machineroom/rpi_c011/PCB/c011_link.kicad_pcb

## KiCad design PCB/c011_link.kicad_pcb (2022-03-19)

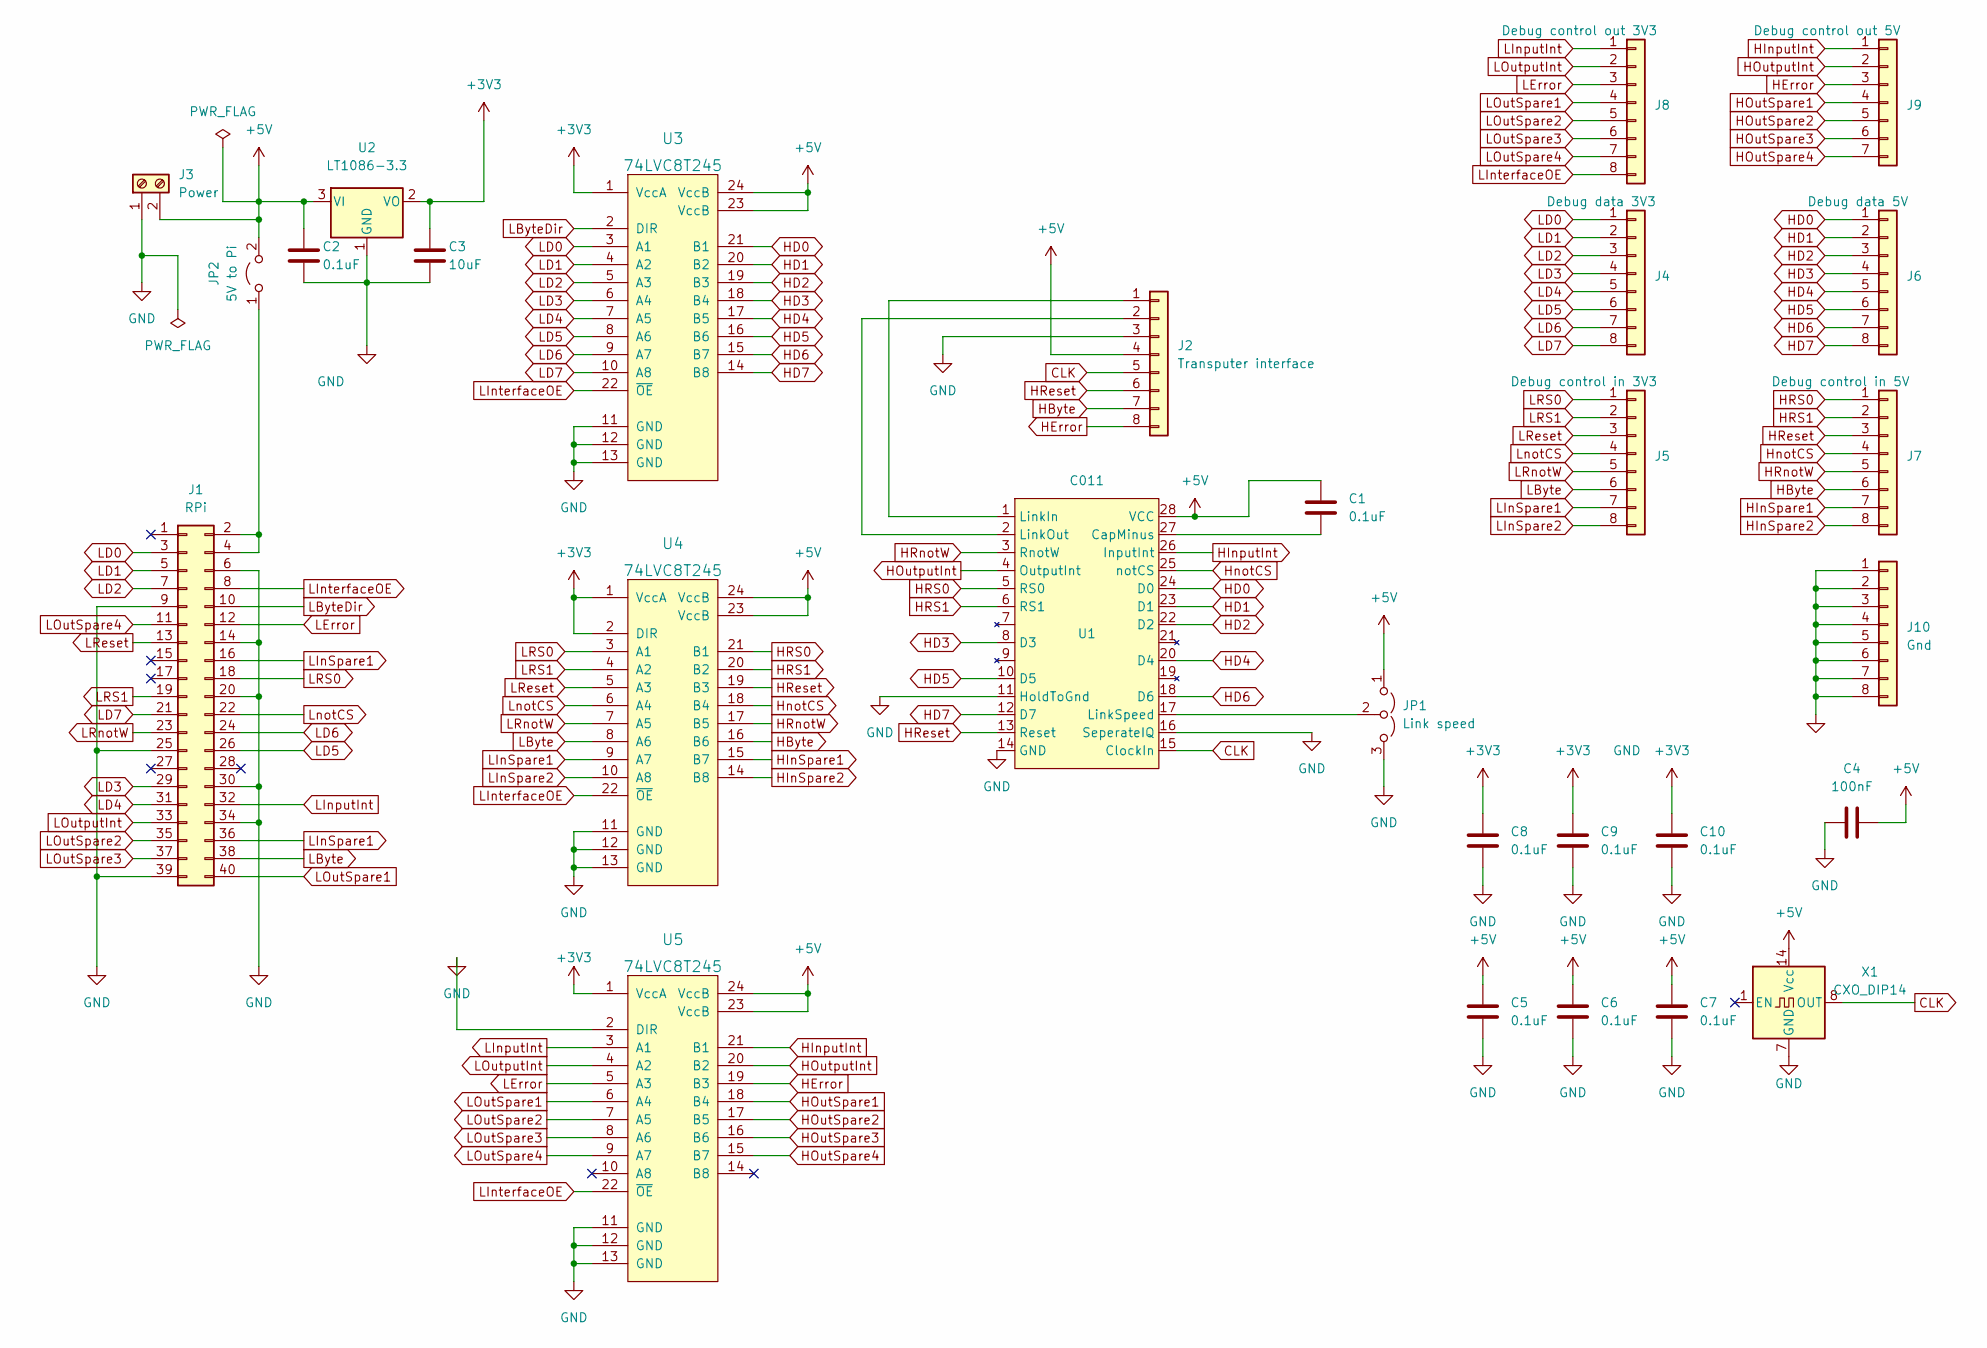
[picture p2: schematic c011_link.kicad_sch]

Parts:
C1, C2: 0.1uF; C_Disc_D5.0mm_W2.5mm_P5.00mm
C3: 10uF; CP_Radial_Tantal_D5.0mm_P2.50mm
C4: 100nF; C_Disc_D5.0mm_W2.5mm_P5.00mm
C5, C6, C7, C8, C9, C10: 0.1uF; C_0402_1005Metric_Pad0.74x0.62mm_HandSolder
J1: RPi; PinHeader_2x20_P2.54mm_Vertical
J2: Transputer interface; PinHeader_1x08_P2.54mm_Vertical
J3: Power; TerminalBlock_bornier-2_P5.08mm
J4: Debug data 3V3; PinHeader_1x08_P2.54mm_Vertical
J5: Debug control in 3V3; PinHeader_1x08_P2.54mm_Vertical
J6: Debug data 5V; PinHeader_1x08_P2.54mm_Vertical
J7: Debug control in 5V; PinHeader_1x08_P2.54mm_Vertical
J8: Debug control out 3V3; PinHeader_1x08_P2.54mm_Vertical
J9: Debug control out 5V; PinHeader_1x07_P2.54mm_Vertical
J10: Gnd; PinHeader_1x08_P2.54mm_Vertical
JP1: Link speed; PinHeader_1x03_P2.54mm_Vertical
JP2: 5V to Pi; PinHeader_1x02_P2.54mm_Vertical
U1: C011; DIP-28_W15.24mm
U2: LT1086-3.3; TO-220-3_Horizontal_TabDown
U3, U4, U5: 74LVC8T245; SOIC-24W_7.5x15.4mm_P1.27mm
X1: CXO_DIP14; Oscillator_DIP-14

Connections:
+3V3: C3.1, C8.1, C9.1, C10.1, U2.2 (VO), U3.1 (VccA), U4.1 (VccA), U4.2 (DIR), U5.1 (VccA)
+5V: C1.1, C2.1, C4.1, C5.1, C6.1, C7.1, J2.4, J3.2, JP1.1 (A), JP2.2 (B), U1.28 (VCC), U2.3 (VI), U3.23 (VccB), U3.24 (VccB), U4.23 (VccB), U4.24 (VccB), U5.23 (VccB), U5.24 (VccB), X1.14 (Vcc)
CLK: J2.5, U1.15 (ClockIn), X1.8 (OUT)
GND: C2.2, C3.2, C4.2, C5.2, C6.2, C7.2, C8.2, C9.2, C10.2, J1.6, J1.9, J1.14, J1.20, J1.25, J1.30, J1.34, J1.39, J2.3, J3.1, J10.1, J10.2, J10.3, J10.4, J10.5, J10.6, J10.7, J10.8, JP1.3 (B), U1.11 (HoldToGnd), U1.14 (GND), U1.16 (SeperateIQ), U2.1 (GND), U3.11 (GND), U3.12 (GND), U3.13 (GND), U4.11 (GND), U4.12 (GND), U4.13 (GND), U5.2 (DIR), U5.11 (GND), U5.12 (GND), U5.13 (GND), X1.7 (GND)
HByte: J2.7, J7.6, U4.16 (B6)
HD0: J6.1, U1.24 (D0), U3.21 (B1)
HD1: J6.2, U1.23 (D1), U3.20 (B2)
HD2: J6.3, U1.22 (D2), U3.19 (B3)
HD3: J6.4, U1.8 (D3), U3.18 (B4)
HD4: J6.5, U1.20 (D4), U3.17 (B5)
HD5: J6.6, U1.10 (D5), U3.16 (B6)
HD6: J6.7, U1.18 (D6), U3.15 (B7)
HD7: J6.8, U1.12 (D7), U3.14 (B8)
HError: J2.8, J9.3, U5.19 (B3)
HInSpare1: J7.7, U4.15 (B7)
HInSpare2: J7.8, U4.14 (B8)
HInputInt: J9.1, U1.26 (InputInt), U5.21 (B1)
HOutSpare1: J9.4, U5.18 (B4)
HOutSpare2: J9.5, U5.17 (B5)
HOutSpare3: J9.6, U5.16 (B6)
HOutSpare4: J9.7, U5.15 (B7)
HOutputInt: J9.2, U1.4 (OutputInt), U5.20 (B2)
HRS0: J7.1, U1.5 (RS0), U4.21 (B1)
HRS1: J7.2, U1.6 (RS1), U4.20 (B2)
HReset: J2.6, J7.3, U1.13 (Reset), U4.19 (B3)
HRnotW: J7.5, U1.3 (RnotW), U4.17 (B5)
HnotCS: J7.4, U1.25 (notCS), U4.18 (B4)
LByte: J1.38, J5.6, U4.8 (A6)
LByteDir: J1.10, U3.2 (DIR)
LD0: J1.3, J4.1, U3.3 (A1)
LD1: J1.5, J4.2, U3.4 (A2)
LD2: J1.7, J4.3, U3.5 (A3)
LD3: J1.29, J4.4, U3.6 (A4)
LD4: J1.31, J4.5, U3.7 (A5)
LD5: J1.26, J4.6, U3.8 (A6)
LD6: J1.24, J4.7, U3.9 (A7)
LD7: J1.21, J4.8, U3.10 (A8)
LError: J1.12, J8.3, U5.5 (A3)
LInSpare1: J1.16, J1.36, J5.7, U4.9 (A7)
LInSpare2: J5.8, U4.10 (A8)
LInputInt: J1.32, J8.1, U5.3 (A1)
LInterfaceOE: J1.8, J8.8, U3.22 (~OE), U4.22 (~OE), U5.22 (~OE)
LOutSpare1: J1.40, J8.4, U5.6 (A4)
LOutSpare2: J1.35, J8.5, U5.7 (A5)
LOutSpare3: J1.37, J8.6, U5.8 (A6)
LOutSpare4: J1.11, J8.7, U5.9 (A7)
LOutputInt: J1.33, J8.2, U5.4 (A2)
LRS0: J1.18, J5.1, U4.3 (A1)
LRS1: J1.19, J5.2, U4.4 (A2)
LReset: J1.13, J5.3, U4.5 (A3)
LRnotW: J1.23, J5.5, U4.7 (A5)
LnotCS: J1.22, J5.4, U4.6 (A4)
unnamed: C1.2, U1.27 (CapMinus)
unnamed: J1.2, J1.4, JP2.1 (A)
unnamed: J2.1, U1.1 (LinkIn)
unnamed: J2.2, U1.2 (LinkOut)
unnamed: JP1.2 (C), U1.17 (LinkSpeed)

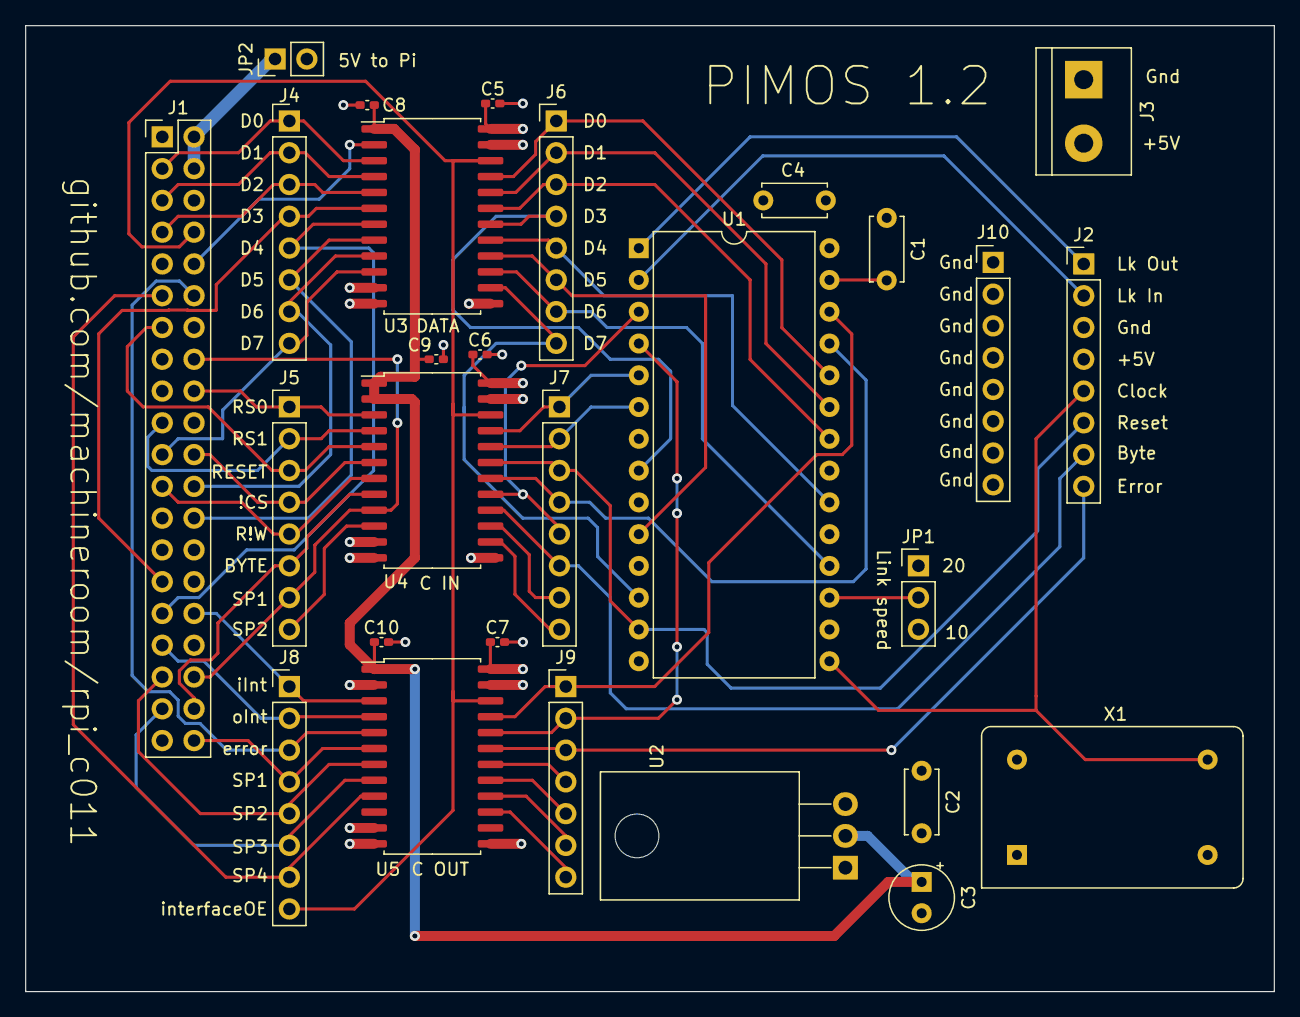
[picture p3: board c011_link.kicad_pcb from above]

Board: 4 copper layers, 99.8 x 77.2 mm, 28 parts (0 on the bottom side), 57 nets.
