machineroom/rpi_c011/boot.c

/*
  Test C011 (mode2) boot a T425
 */

#include <stdint.h>
#include <unistd.h>
#include <stdio.h>
#include <stdlib.h>
#include <getopt.h>
#include <fcntl.h>
#include <string.h>
#include <sys/ioctl.h>
#include <linux/types.h>
#include <stdbool.h>
#include <time.h>
#include "c011.h"
#include <bcm2835.h>

//#define MULTI_WORD

int main(int argc, char *argv[])
{
	int ret = 0;
	c011_init();
    c011_reset();
    c011_set_byte_mode();

//    c011_analyse();
    //blatant copy from https://github.com/hessch/rpilink/blob/master/utils/tdetect.py
    // & http://www.geekdot.com/category/software/transputer-software/ (iTest)
#ifdef MULTI_WORD
    uint8_t boot[] = 
            {
             0,                                         /* size of bootstrap */
             0xB1,                                      /* AJW 1, allow for Iptr store    */
             0xD1,                                      /* STL 1                          */
             0x24, 0xF2,                                /* MINT                           */
             0x21, 0xFC,                                /* STHF                           */
             0x24, 0xF2,                                /* MINT                           */
             0x21, 0xF8,                                /* STLF                           */
             0xF0,                                      /* REV                            */
             0x60, 0x5C,                                /* LDNLP -4                       */
             0x40,                                      /* LDC #0                        */
             0xFF,                                      /* OUTWORD                        */
             0x28, 0x48,                                /* LDC #88                        */
             0xFF,                                      /* OUTWORD                        */
             0x28, 0x28, 0x28, 0x28, 0x28, 0x28, 0x28, 0x48,  /* LDC #88888888            */
             0xFF,                                      /* OUTWORD                        */
             0x21, 0x21, 0x21, 0x21, 0x21, 0x21, 0x21, 0x41,  /* LDC #11111111            */
             0xFF,                                      /* OUTWORD                        */
             0x2A, 0x4A,                                /* PFX A, LDC #A                        */
             0xFF,                                      /* OUTWORD                        */
             0x2B, 0x2B, 0x2B, 0x4B,                    /* LDC #BBBB                      */
             0xFF,                                      /* OUTWORD                        */
             0x2C, 0x2C, 0x2C, 0x2C, 0x2C, 0x4C,        /* LDC #CCCCCC                      */
             0xFF,                                      /* OUTWORD                        */
             0x2D, 0x2D, 0x2D, 0x2D, 0x2D, 0x2D, 0x2D, 0x4D, /* LDC #DDDDDDDD                    */
             0xFF,                                      /* OUTWORD                        */
             0x21, 0x2F, 0xFF                           /* START                          */
             };  
#else
    uint8_t boot[] = 
            {
             0,                                         /* size of bootstrap */
             0xB1,                                      /* AJW 1, allow for Iptr store    */
             0xD1,                                      /* STL 1                          */
             0x24, 0xF2,                                /* MINT                           */
             0x21, 0xFC,                                /* STHF                           */
             0x24, 0xF2,                                /* MINT                           */
             0x21, 0xF8,                                /* STLF                           */
             0xF0,                                      /* REV                            */
             0x60, 0x5C,                                /* LDNLP -4                       */
             0x2A, 0x2A, 0x2A, 0x4A,                    /* LDC #AAAA                      */
             0xFF,                                      /* OUTWORD                        */
             0x60, 0x5C,                                /* LDNLP -4                       */
             0x21, 0x27, 0xFC,                          /* LDDEVID                        */
             0xFF,                                      /* OUTWORD                        */
             0x21, 0x2F, 0xFF                           /* START                          */
             };  
#endif
    boot[0] = sizeof (boot)-1;  /*"If the first byte received is 2 or greater then that many bytes of code 
                                   will be input from the link and placed in memory starting at MEMSTART.
                                   This code will then be executed."
                                   http://www.wizzy.com/wizzy/transputer_faq.txt*/
    uint8_t rx[4];
    memset(rx,0,sizeof(rx));
    uint32_t num;
    printf ("write %ld bytes to link\n",sizeof(boot)); 
    ret = c011_write_bytes (boot, sizeof(boot), 200);
    if (ret != sizeof(boot)) {
        printf ("failed to write bootstrap - ret = %d\n", ret);
        exit(-1);
    }
    //c011_dump_stats ("write bootstrap");
#ifdef MULTI_WORD
    num = c011_read_bytes (rx, sizeof(rx), 200);
    printf ("num read = %u, expect [00 00 00 00] reply = [%02X %02X %02X %02X]\n", num, rx[0], rx[1], rx[2], rx[3]);
    num = c011_read_bytes (rx, sizeof(rx), 200);
    printf ("num read = %u, expect [88 00 00 00] reply = [%02X %02X %02X %02X]\n", num, rx[0], rx[1], rx[2], rx[3]);
    num = c011_read_bytes (rx, sizeof(rx), 200);
    printf ("num read = %u, expect [88 88 88 88] reply = [%02X %02X %02X %02X]\n", num, rx[0], rx[1], rx[2], rx[3]);
    num = c011_read_bytes (rx, sizeof(rx), 200);
    printf ("num read = %u, expect [11 11 11 11] reply = [%02X %02X %02X %02X]\n", num, rx[0], rx[1], rx[2], rx[3]);
    num = c011_read_bytes (rx, sizeof(rx), 200);
    printf ("num read = %u, expect [AA 00 00 00] reply = [%02X %02X %02X %02X]\n", num, rx[0], rx[1], rx[2], rx[3]);
    num = c011_read_bytes (rx, sizeof(rx), 200);
    printf ("num read = %u, expect [BB BB 00 00] reply = [%02X %02X %02X %02X]\n", num, rx[0], rx[1], rx[2], rx[3]);
    num = c011_read_bytes (rx, sizeof(rx), 200);
    printf ("num read = %u, expect [CC CC CC 00] reply = [%02X %02X %02X %02X]\n", num, rx[0], rx[1], rx[2], rx[3]);
    num = c011_read_bytes (rx, sizeof(rx), 200);
    printf ("num read = %u, expect [DD DD DD DD] reply = [%02X %02X %02X %02X]\n", num, rx[0], rx[1], rx[2], rx[3]);
#else
    num = c011_read_bytes (rx, sizeof(rx), 200);
    printf ("num read = %u, expect [AA AA 00 00 xx xx] reply = [%02X %02X %02X %02X %02X %02X]\n", num, rx[0], rx[1], rx[2], rx[3], rx[4], rx[5]);
    //c011_dump_stats ("read result");
    num = c011_read_bytes (rx, sizeof(rx), 200);
    printf ("num reaD = %u, devid [%02X %02X %02X %02X %02X %02X]\n", num, rx[0], rx[1], rx[2], rx[3], rx[4], rx[5]);
#endif
	return ret;
}
