machineroom/rpi_c011/(commit log)

2019-09-26 tighten up timing
2019-09-26 move c011 to library. added bootstrap. loopback OK if TRAM not powered and not comsuming clock. needs clock boost + seperate PSU for TRAM
2022-01-08 Added PCB files
    [c011_link.kicad_pcb, c011_link.kicad_sch]
2022-01-29 Add link pin to pulseview
2022-02-01 Record all failed byte values
    [c011.c, c011_loopback.c]
2022-02-04 resolving random incorrect bytes with good power
2022-02-04 print total bytes in loopback
2022-02-05 Update to PCB 1.1 design
    [c011_link.kicad_pcb, c011_link.kicad_sch]
2022-03-12 Use BYTE output as error indicator for c011 testing
    [c011.c, c011_loopback.c]
2022-03-19 Bootstrap testing now works OK with no ribbon cable from pi to c011
2022-03-19 move to 74LVC8T245 level converters
    The existing auto detecting direction shifters can glitch into the 'wrong' direction
    [c011_link.kicad_pcb, c011_link.kicad_sch]
2022-12-29 move all wx specific stuff out of c011 driver
